c0pperdragon/ByteMachine/i8088/i8088board.pdf

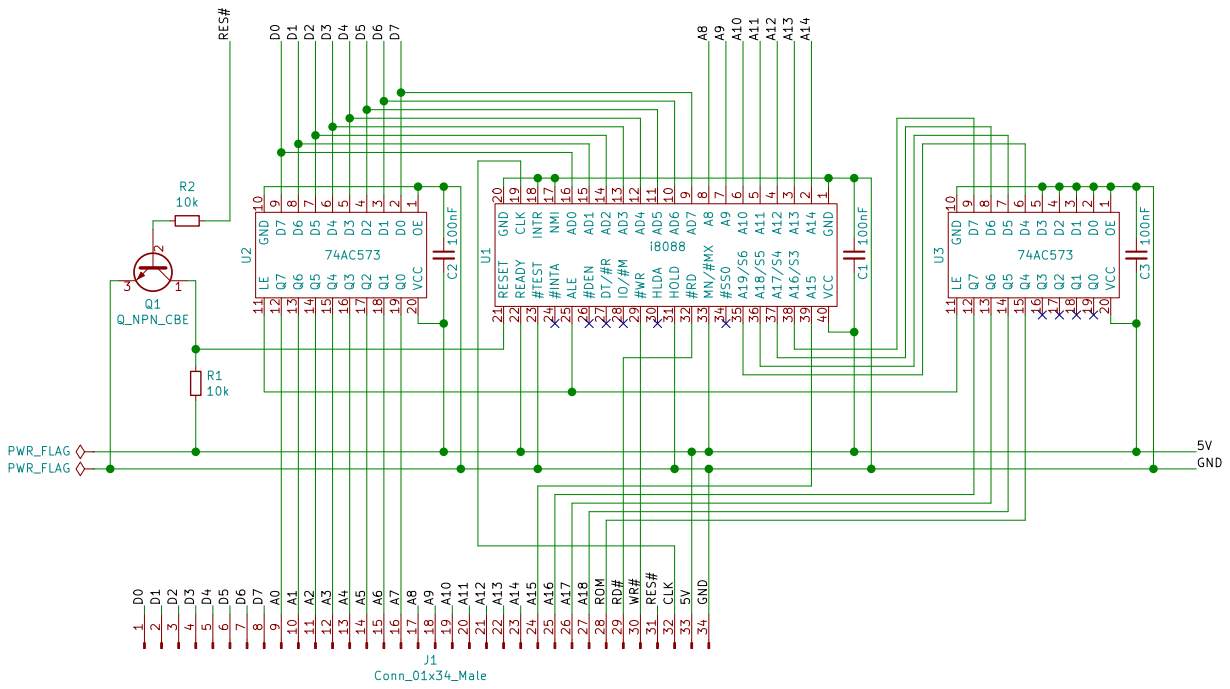
[picture p8: page 1]

2 GND 20 RESET 21 READY 22 #TEST 23 #INTA 24 ALE 25 #DEN 26 DT/#R 27 IO/#M 28 #WR 29 A13

3 HLDA 30 HOLD 31 #RD 32 MN/#MX 33 #SS0 34 A19/S6 35 A18/S5 36 A17/S4 37 A16/S3 38 A15 39 A12
