c0pperdragon/ByteMachine/z84c00/z84c00board.pdf

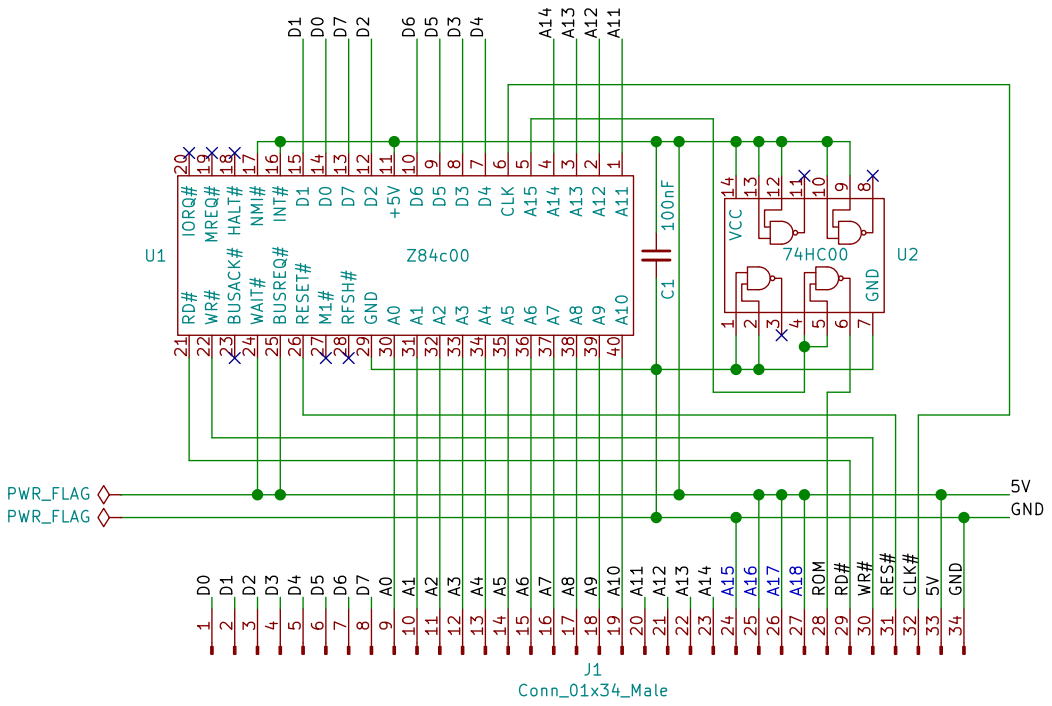
[picture p9: page 1]

2 IORQ# 20 RD# 21 WR# 22 BUSACK# 23 WAIT# 24 BUSREQ# 25 RESET# 26 M1# 27 RFSH# 28 GND 29 A13

1 D6 10 +5V 11 D2 12 D7 13 D0 14 D1 15 INT# 16 NMI# 17 HALT# 18 MREQ# 19 A12
