c0pperdragon/ByteMachine/6809/6809P-Schematic.pdf

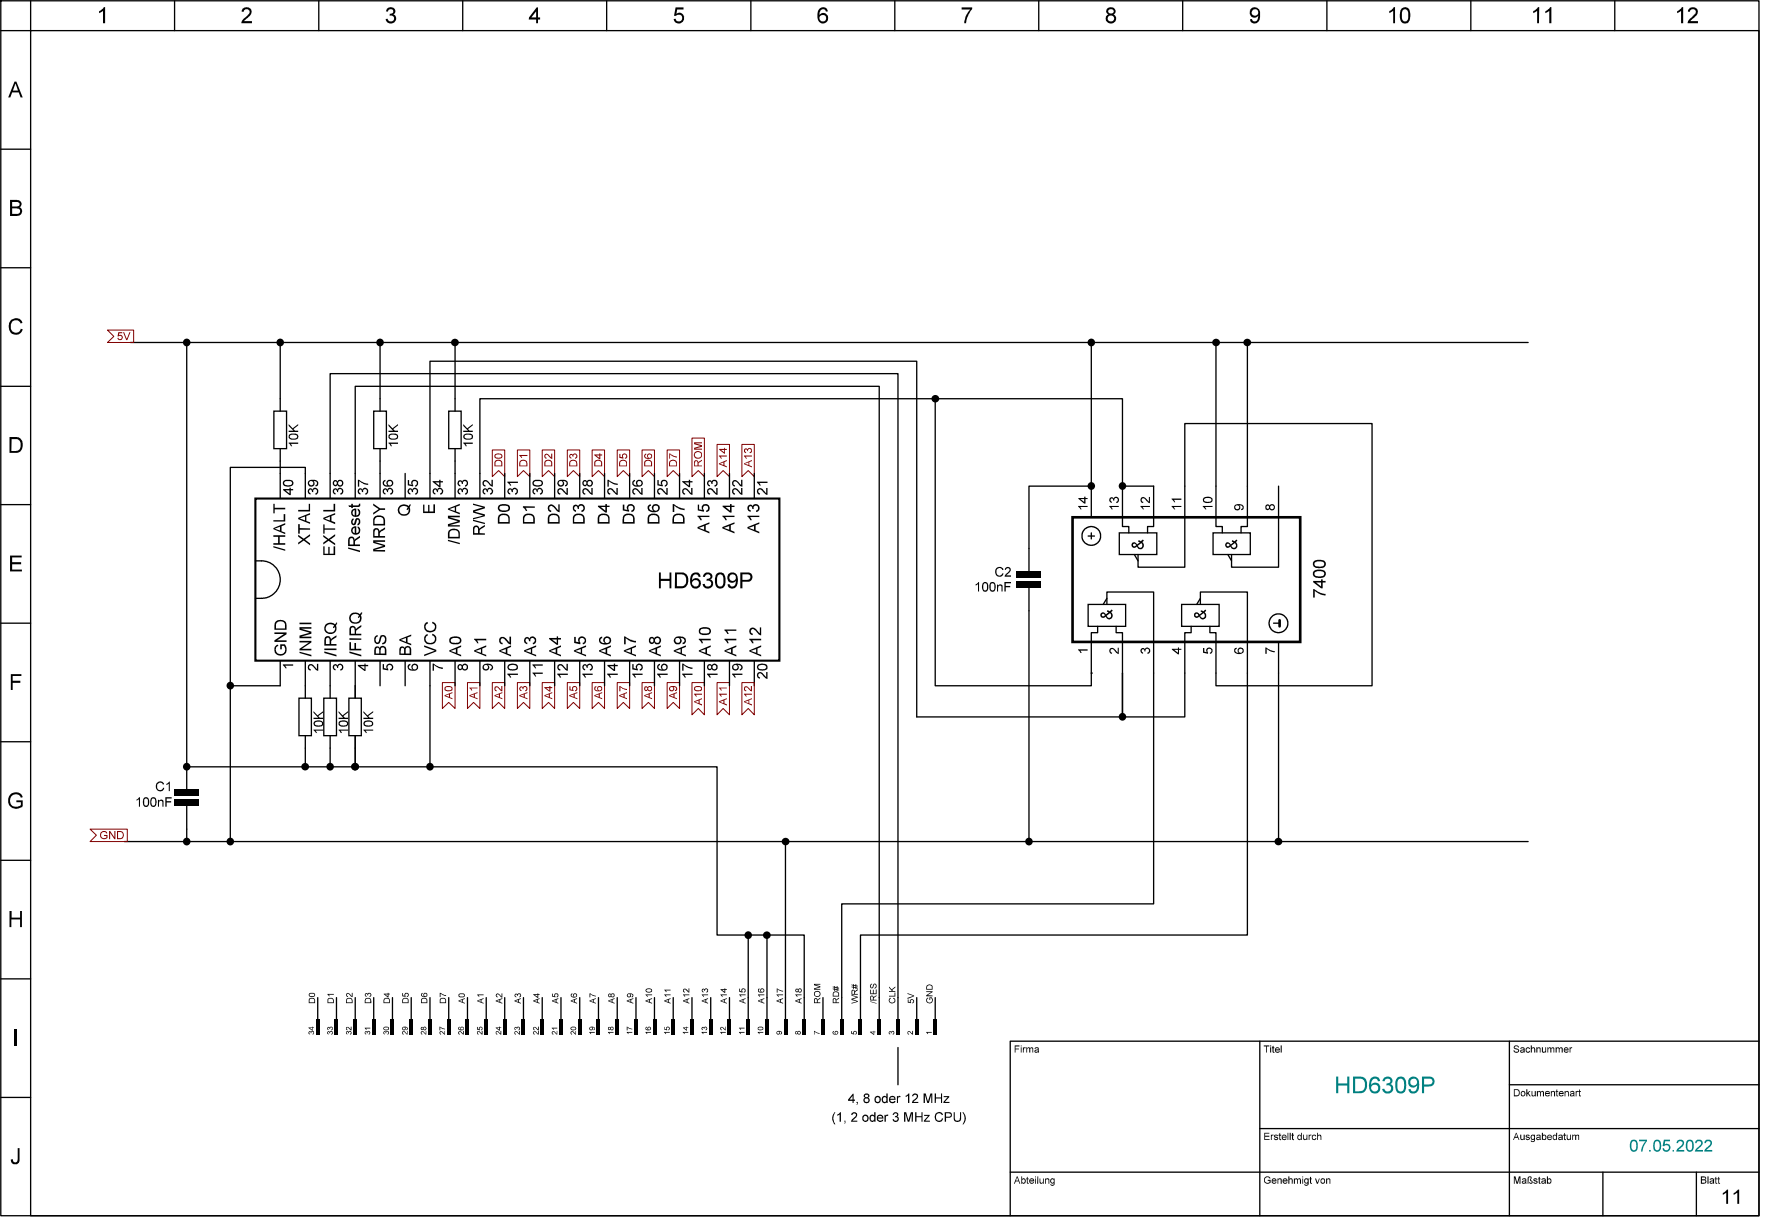
[picture p10: page 1]
