c0pperdragon/ByteMachine/IOexpander/ioexpanderboard.pdf

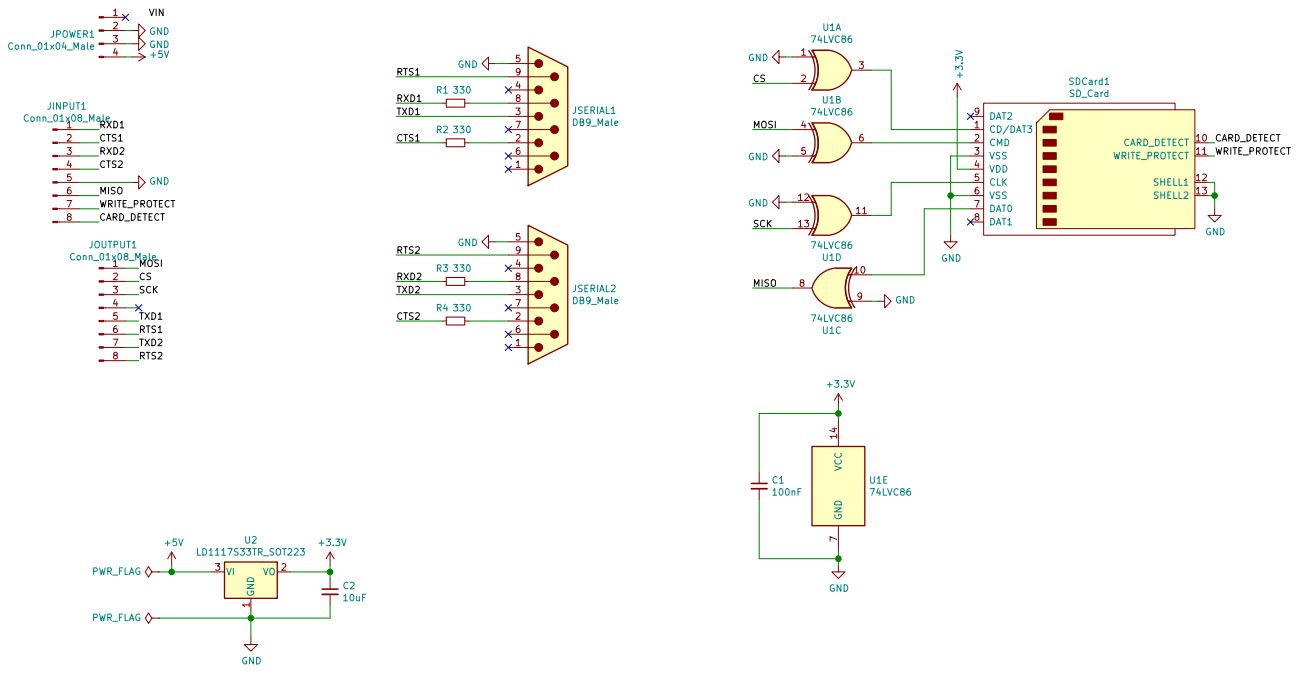
[picture p11: page 1]
