c0pperdragon/ByteMachine/65c02/65c02board.pdf

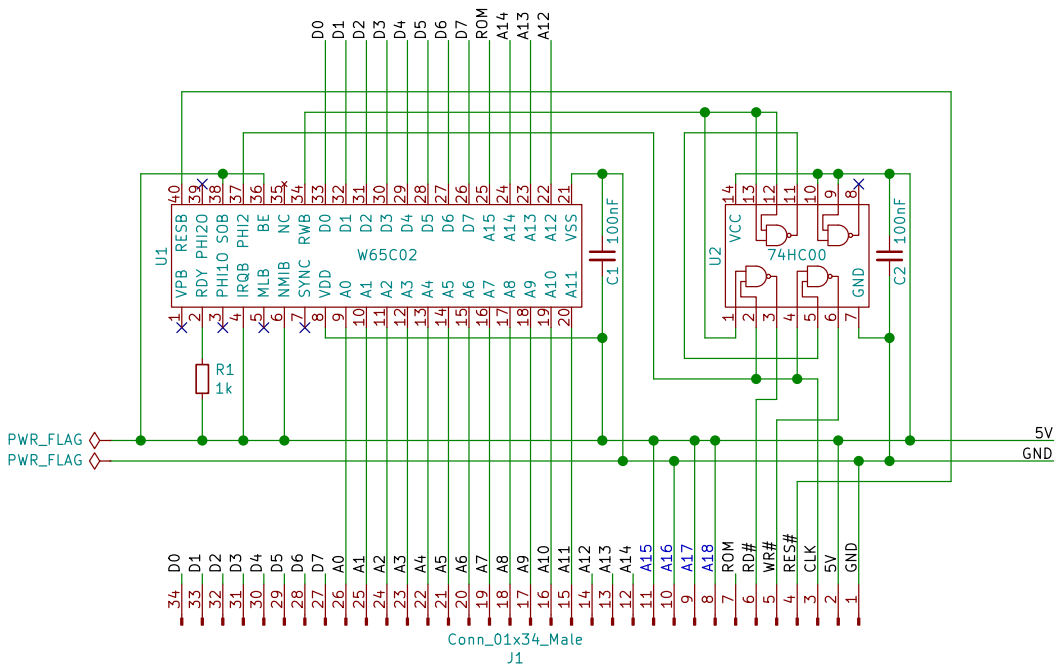
[picture p12: page 1]

3 D3 30 D2 31 D1 32 D0 33 RWB 34 NC 35 BE 36 PHI2 37 SOB 38 PHI2O 39 IRQB
