c0pperdragon/ByteMachine/mainboard/mainboard.pdf

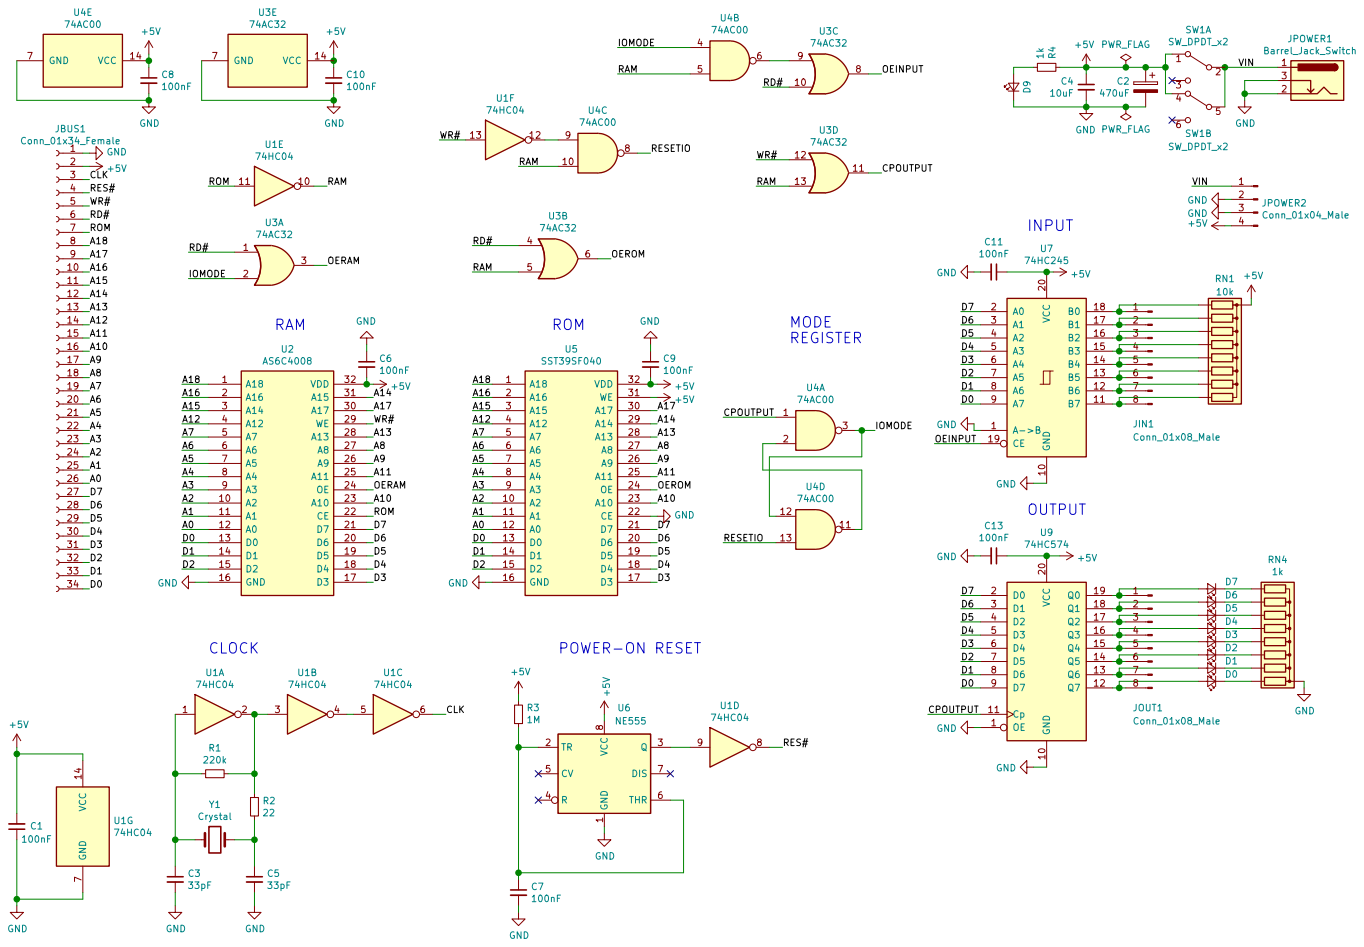
[picture p13: page 1]
