c0pperdragon/ByteMachine/65c816/65c816board.pdf

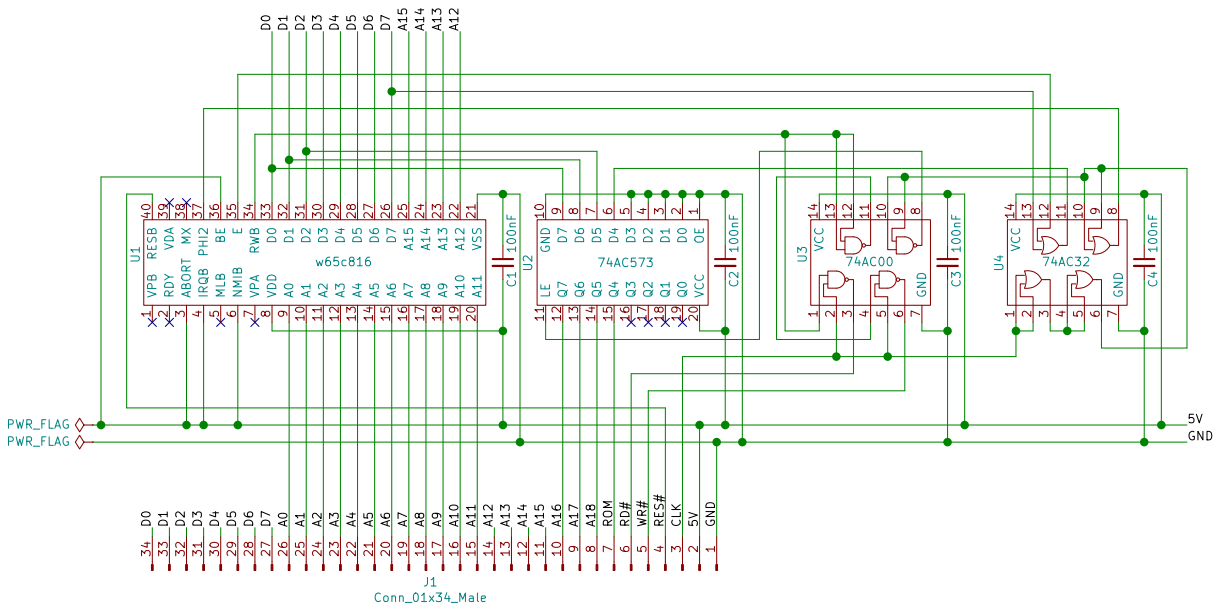
[picture p14: page 1]

3 D3 30 D2 31 D1 32 D0 33 RWB 34 E 35 BE 36 PHI2 37 MX 38 VDA 39 IRQB

9 U1 w65c816 D0 D1 D2 D3 D4 D5 D6 D7 RD# WR# RES# CLK 5VGND
