c0pperdragon/ByteMachine/IOexpander/ioexpanderboard/ioexpanderboard.kicad_pcb

## KiCad design IOexpander/ioexpanderboard/ioexpanderboard.kicad_pcb (2021-04-02)

Schematic: ioexpanderboard.sch

Parts:
C1: 100nF; C_0805_2012Metric_Pad1.15x1.40mm_HandSolder
C2: 10uF; C_0805_2012Metric_Pad1.15x1.40mm_HandSolder
JINPUT1: Conn_01x08_Male; PinHeader_1x08_P2.54mm_Vertical
JOUTPUT1: Conn_01x08_Male; PinHeader_1x08_P2.54mm_Vertical
JPOWER1: Conn_01x04_Male; PinHeader_1x04_P2.54mm_Vertical
JSERIAL1, JSERIAL2: DB9_Male; DSUB-9_Male_Horizontal_P2.77x2.54mm_EdgePinOffset9.40mm
R1, R2, R3, R4: 330; R_0805_2012Metric_Pad1.15x1.40mm_HandSolder
SDCard1: SD_Card; sdcardsocket
U1: 74LVC86; SOIC-14_3.9x8.7mm_P1.27mm
U2: LD1117S33TR_SOT223; SOT-223-3_TabPin2

Connections:
+3V3: C1.1, C2.1, SDCard1.4, U1.14 (VCC), U2.2 (VO)
+5V: JPOWER1.4, U2.3 (VI)
/CARD_DETECT: JINPUT1.8, SDCard1.10
/CS: JOUTPUT1.2, U1.2
/CTS1: JINPUT1.2, R2.2
/CTS2: JINPUT1.4, R4.2
/MISO: JINPUT1.6, U1.8
/MOSI: JOUTPUT1.1, U1.4
/RTS1: JOUTPUT1.6, JSERIAL1.9
/RTS2: JOUTPUT1.8, JSERIAL2.9
/RXD1: JINPUT1.1, R1.2
/RXD2: JINPUT1.3, R3.2
/SCK: JOUTPUT1.3, U1.13
/TXD1: JOUTPUT1.5, JSERIAL1.3
/TXD2: JOUTPUT1.7, JSERIAL2.3
/WRITE_PROTECT: JINPUT1.7, SDCard1.11
GND: C1.2, C2.2, JINPUT1.5, JPOWER1.2, JPOWER1.3, JSERIAL1.5, JSERIAL2.5, SDCard1.3, SDCard1.6, SDCard1.12, SDCard1.13, U1.1, U1.5, U1.7 (GND), U1.9, U1.12, U2.1 (GND)
unnamed: JSERIAL1.2, R2.1
unnamed: JSERIAL1.8, R1.1
unnamed: JSERIAL2.2, R4.1
unnamed: JSERIAL2.8, R3.1
unnamed: SDCard1.1, U1.3
unnamed: SDCard1.2, U1.6
unnamed: SDCard1.5, U1.11
unnamed: SDCard1.7, U1.10

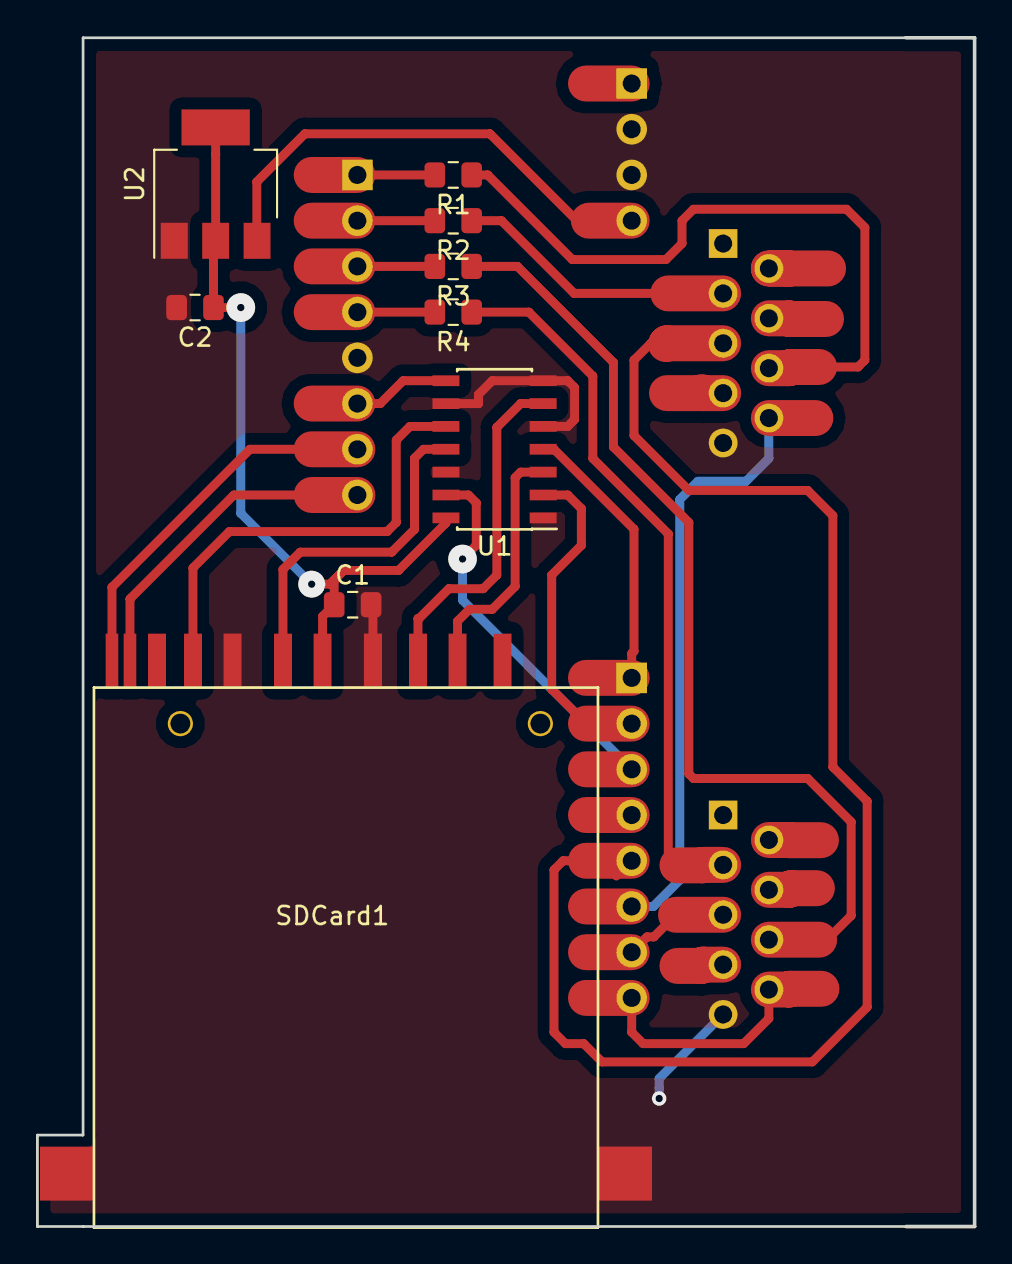
[picture p15: board ioexpanderboard.kicad_pcb from above]

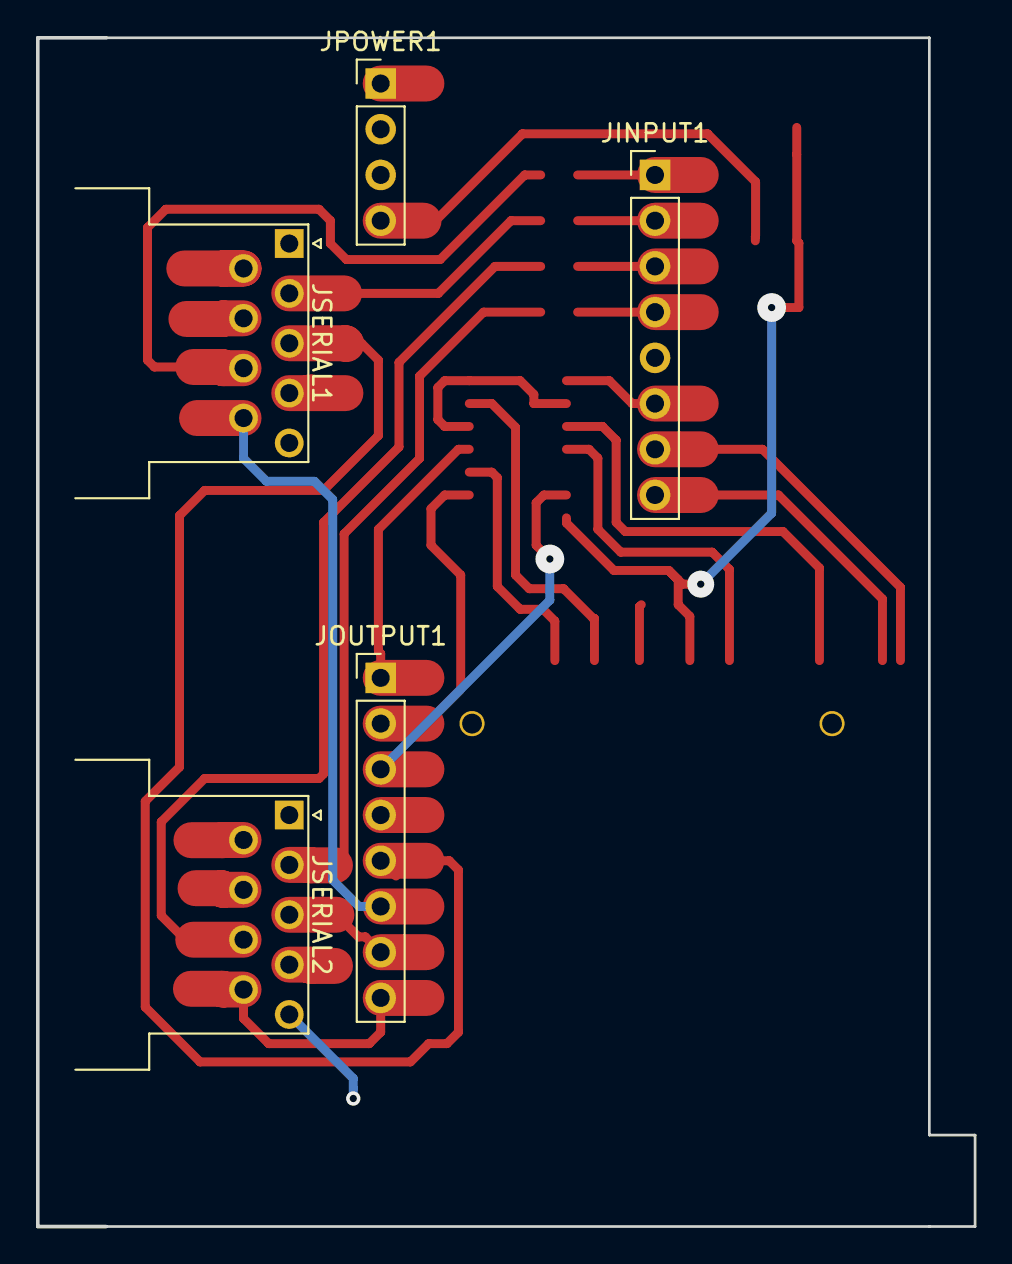
[picture p16: board ioexpanderboard.kicad_pcb from below]

Board: 2 copper layers, 52.1 x 66.0 mm, 14 parts (5 on the bottom side), 25 nets.
