c0pperdragon/ByteMachine/65c816/65c816board/65c816board.kicad_pcb

## KiCad design 65c816/65c816board/65c816board.kicad_pcb (2021-04-02)

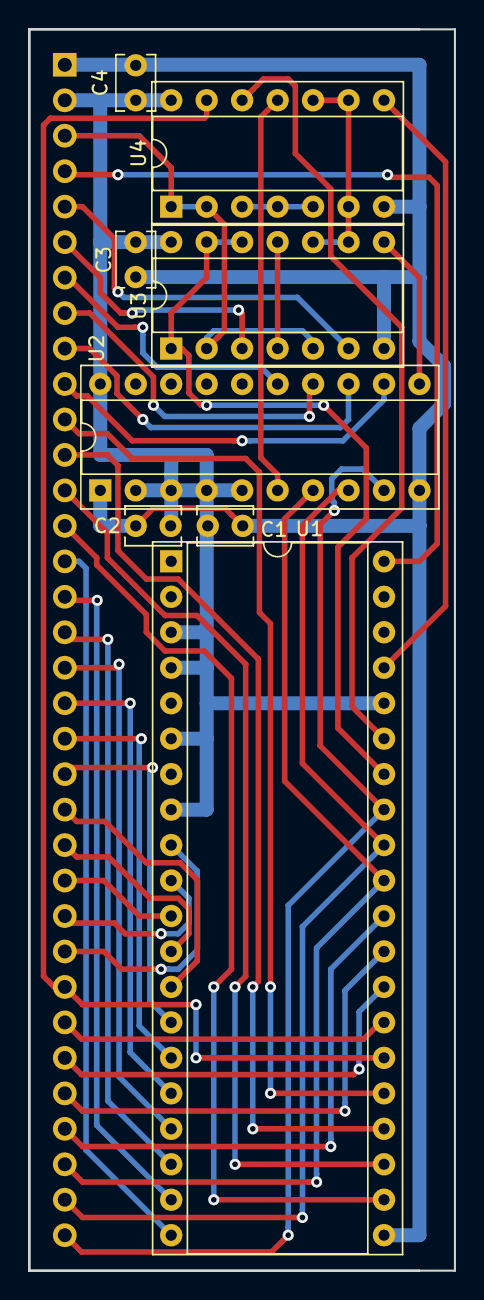
[picture p17: board 65c816board.kicad_pcb from above]

Board: 2 copper layers, 30.5 x 88.9 mm, 9 parts (1 on the bottom side), 42 nets.

Parts:
C1, C2, C3, C4: 100nF; C_Disc_D3.8mm_W2.6mm_P2.50mm
J1: Conn_01x34_Male; PinHeader_1x34_P2.54mm_Vertical
U1: w65c816; DIP-40_W15.24mm_Socket
U2: 74AC573; DIP-20_W7.62mm_Socket
U3: 74AC00; DIP-14_W7.62mm_Socket
U4: 74AC32; DIP-14_W7.62mm_Socket

Connections:
/5V: C1.2, C2.2, C3.1, C4.1, J1.2, U1.3, U1.4, U1.6, U1.8, U1.36, U2.2, U2.3, U2.4, U2.5, U2.20, U3.14, U4.14
/A0: J1.26, U1.9
/A1: J1.25, U1.10
/A2: J1.24, U1.11
/A3: J1.23, U1.12
/A4: J1.22, U1.13
/A5: J1.21, U1.14
/A6: J1.20, U1.15
/A7: J1.19, U1.16
/A8: J1.18, U1.17
/A9: J1.17, U1.18
/A10: J1.16, U1.19
/A11: J1.15, U1.20
/A12: J1.14, U1.22
/A13: J1.13, U1.23
/A14: J1.12, U1.24
/A15: J1.11, U1.25
/A16: J1.10, U2.12
/A17: J1.9, U2.13
/A18: J1.8, U2.14
/CLK: J1.3, U3.2, U3.5, U4.1, U4.2
/D0: J1.34, U1.33, U2.9
/D1: J1.33, U1.32, U2.8
/D2: J1.32, U1.31, U2.7
/D3: J1.31, U1.30
/D4: J1.30, U1.29
/D5: J1.29, U1.28
/D6: J1.28, U1.27
/D7: J1.27, U1.26, U4.13
/GND: C1.1, C2.1, C3.2, C4.2, J1.1, U1.21, U2.1, U2.10, U3.7, U4.7
/RD#: J1.6, U3.3
/RES#: J1.4, U1.40
/ROM: J1.7, U2.15
/WR#: J1.5, U3.6
unnamed: U1.34, U3.1, U3.12, U3.13
unnamed: U1.35, U4.12
unnamed: U1.37, U4.8
unnamed: U2.6, U4.11
unnamed: U2.11, U3.8
unnamed: U3.9, U3.10, U4.6, U4.9, U4.10
unnamed: U3.4, U3.11
unnamed: U4.3, U4.4, U4.5
