c0pperdragon/ByteMachine/mainboard/mainboard.kicad_pcb

## KiCad design mainboard/mainboard.kicad_pcb (2020-08-21)

Schematic: mainboard.sch, Byte machine - main board

Parts:
C1, C6, C7, C8, C9, C10, C11, C13: 100nF; C_Disc_D3.8mm_W2.6mm_P2.50mm
C2: 470uF; CP_Radial_D8.0mm_P5.00mm
C3, C5: 33pF; C_Disc_D5.0mm_W2.5mm_P5.00mm
C4: 10uF; C_Disc_D5.0mm_W2.5mm_P5.00mm
D0, D1, D2, D3, D4, D5, D6, D7, D9: LED_Small; LED_D3.0mm
JBUS1: Conn_01x34_Female; PinSocket_1x34_P2.54mm_Vertical
JIN1: Conn_01x08_Male; PinHeader_1x08_P2.54mm_Vertical
JOUT1: Conn_01x08_Male; PinHeader_1x08_P2.54mm_Vertical
JPOWER1: Barrel_Jack_Switch; BarrelJack_Horizontal
JPOWER2: Conn_01x04_Male; PinHeader_1x04_P2.54mm_Vertical
R1: 220k; R_Axial_DIN0207_L6.3mm_D2.5mm_P7.62mm_Horizontal
R2: 22; R_Axial_DIN0207_L6.3mm_D2.5mm_P7.62mm_Horizontal
R3: 1M; R_Axial_DIN0207_L6.3mm_D2.5mm_P7.62mm_Horizontal
R4: 1k; R_Axial_DIN0207_L6.3mm_D2.5mm_P7.62mm_Horizontal
RN1: 10k; R_Array_SIP9
RN4: 1k; R_Array_SIP9
SW1: SW_DPDT_x2; DPDS Switch
U1: 74HC04; DIP-14_W7.62mm_Socket
U2: AS6C4008; DIP-32_W15.24mm_Socket
U3: 74AC32; DIP-14_W7.62mm_Socket
U4: 74AC00; DIP-14_W7.62mm_Socket
U5: SST39SF040; DIP-32_LargeHoles
U6: NE555; DIP-8_W7.62mm
U7: 74HC245; DIP-20_W7.62mm_Socket
U9: 74HC574; DIP-20_W7.62mm_Socket
Y1: Crystal; Crystal_HC18-U_Vertical

Connections:
+5V: C1.2, C2.1, C4.1, C6.2, C8.1, C9.2, C10.1, C11.1, C13.1, JBUS1.2, JPOWER2.4, R3.2, R4.1, RN1.1, SW1.1, SW1.4, U1.14 (VCC), U2.32, U3.14, U4.14 (VCC), U5.31, U5.32, U6.8 (VCC), U7.20 (VCC), U9.20 (VCC)
/A0: JBUS1.26, U2.12, U5.12
/A1: JBUS1.25, U2.11, U5.11
/A2: JBUS1.24, U2.10, U5.10
/A3: JBUS1.23, U2.9, U5.9
/A4: JBUS1.22, U2.8, U5.8
/A5: JBUS1.21, U2.7, U5.7
/A6: JBUS1.20, U2.6, U5.6
/A7: JBUS1.19, U2.5, U5.5
/A8: JBUS1.18, U2.27, U5.27
/A9: JBUS1.17, U2.26, U5.26
/A10: JBUS1.16, U2.23, U5.23
/A11: JBUS1.15, U2.25, U5.25
/A12: JBUS1.14, U2.4, U5.4
/A13: JBUS1.13, U2.28, U5.28
/A14: JBUS1.12, U2.31, U5.29
/A15: JBUS1.11, U2.3, U5.3
/A16: JBUS1.10, U2.2, U5.2
/A17: JBUS1.9, U2.30, U5.30
/A18: JBUS1.8, U2.1, U5.1
/CLK: JBUS1.3, U1.6
/CPOUTPUT: U3.11, U4.1, U9.11 (Cp)
/D0: JBUS1.34, U2.13, U5.13, U7.9 (A7), U9.9 (D7)
/D1: JBUS1.33, U2.14, U5.14, U7.8 (A6), U9.8 (D6)
/D2: JBUS1.32, U2.15, U5.15, U7.7 (A5), U9.7 (D5)
/D3: JBUS1.31, U2.17, U5.17, U7.6 (A4), U9.6 (D4)
/D4: JBUS1.30, U2.18, U5.18, U7.5 (A3), U9.5 (D3)
/D5: JBUS1.29, U2.19, U5.19, U7.4 (A2), U9.4 (D2)
/D6: JBUS1.28, U2.20, U5.20, U7.3 (A1), U9.3 (D1)
/D7: JBUS1.27, U2.21, U5.21, U7.2 (A0), U9.2 (D0)
/IOMODE: U3.2, U4.3, U4.4, U4.12
/OEINPUT: U3.8, U7.19 (CE)
/OERAM: U2.24, U3.3
/OEROM: U3.6, U5.24
/RAM: U1.10, U3.5, U3.13, U4.5, U4.10
/RD#: JBUS1.6, U3.1, U3.4, U3.10
/RES#: JBUS1.4, U1.8
/RESETIO: U4.8, U4.13
/ROM: JBUS1.7, U1.11, U2.22
/VIN: JPOWER1.1, JPOWER2.1, SW1.2, SW1.5
/WR#: JBUS1.5, U1.13, U2.29, U3.12
GND: C1.1, C2.2, C3.2, C4.2, C5.2, C6.1, C7.2, C8.2, C9.1, C10.2, C11.2, C13.2, D9.1, JBUS1.1, JPOWER1.2, JPOWER1.3, JPOWER2.2, JPOWER2.3, RN4.1, U1.7 (GND), U2.16, U3.7, U4.7 (GND), U5.16, U5.22, U6.1 (GND), U7.1 (A->B), U7.10 (GND), U9.1 (OE), U9.10 (GND)
unnamed: C3.1, R1.2, U1.1, Y1.1
unnamed: C5.1, R2.2, Y1.2
unnamed: C7.1, R3.1, U6.2 (TR), U6.6 (THR)
unnamed: D0.1, RN4.2
unnamed: D0.2, JOUT1.8, U9.12 (Q7)
unnamed: D1.1, RN4.3
unnamed: D1.2, JOUT1.7, U9.13 (Q6)
unnamed: D2.1, RN4.4
unnamed: D2.2, JOUT1.6, U9.14 (Q5)
unnamed: D3.1, RN4.5
unnamed: D3.2, JOUT1.5, U9.15 (Q4)
unnamed: D4.1, RN4.6
unnamed: D4.2, JOUT1.4, U9.16 (Q3)
unnamed: D5.1, RN4.7
unnamed: D5.2, JOUT1.3, U9.17 (Q2)
unnamed: D6.1, RN4.8
unnamed: D6.2, JOUT1.2, U9.18 (Q1)
unnamed: D7.1, RN4.9
unnamed: D7.2, JOUT1.1, U9.19 (Q0)
unnamed: D9.2, R4.2
unnamed: JIN1.1, RN1.2, U7.18 (B0)
unnamed: JIN1.2, RN1.3, U7.17 (B1)
unnamed: JIN1.3, RN1.4, U7.16 (B2)
unnamed: JIN1.4, RN1.5, U7.15 (B3)
unnamed: JIN1.5, RN1.6, U7.14 (B4)
unnamed: JIN1.6, RN1.7, U7.13 (B5)
unnamed: JIN1.7, RN1.8, U7.12 (B6)
unnamed: JIN1.8, RN1.9, U7.11 (B7)
unnamed: R1.1, R2.1, U1.2, U1.3
unnamed: U1.4, U1.5
unnamed: U1.9, U6.3 (Q)
unnamed: U1.12, U4.9
unnamed: U3.9, U4.6
unnamed: U4.2, U4.11

Notes on the sheet:
RAM
ROM
INPUT
OUTPUT
MODE REGISTER
CLOCK
POWER-ON RESET

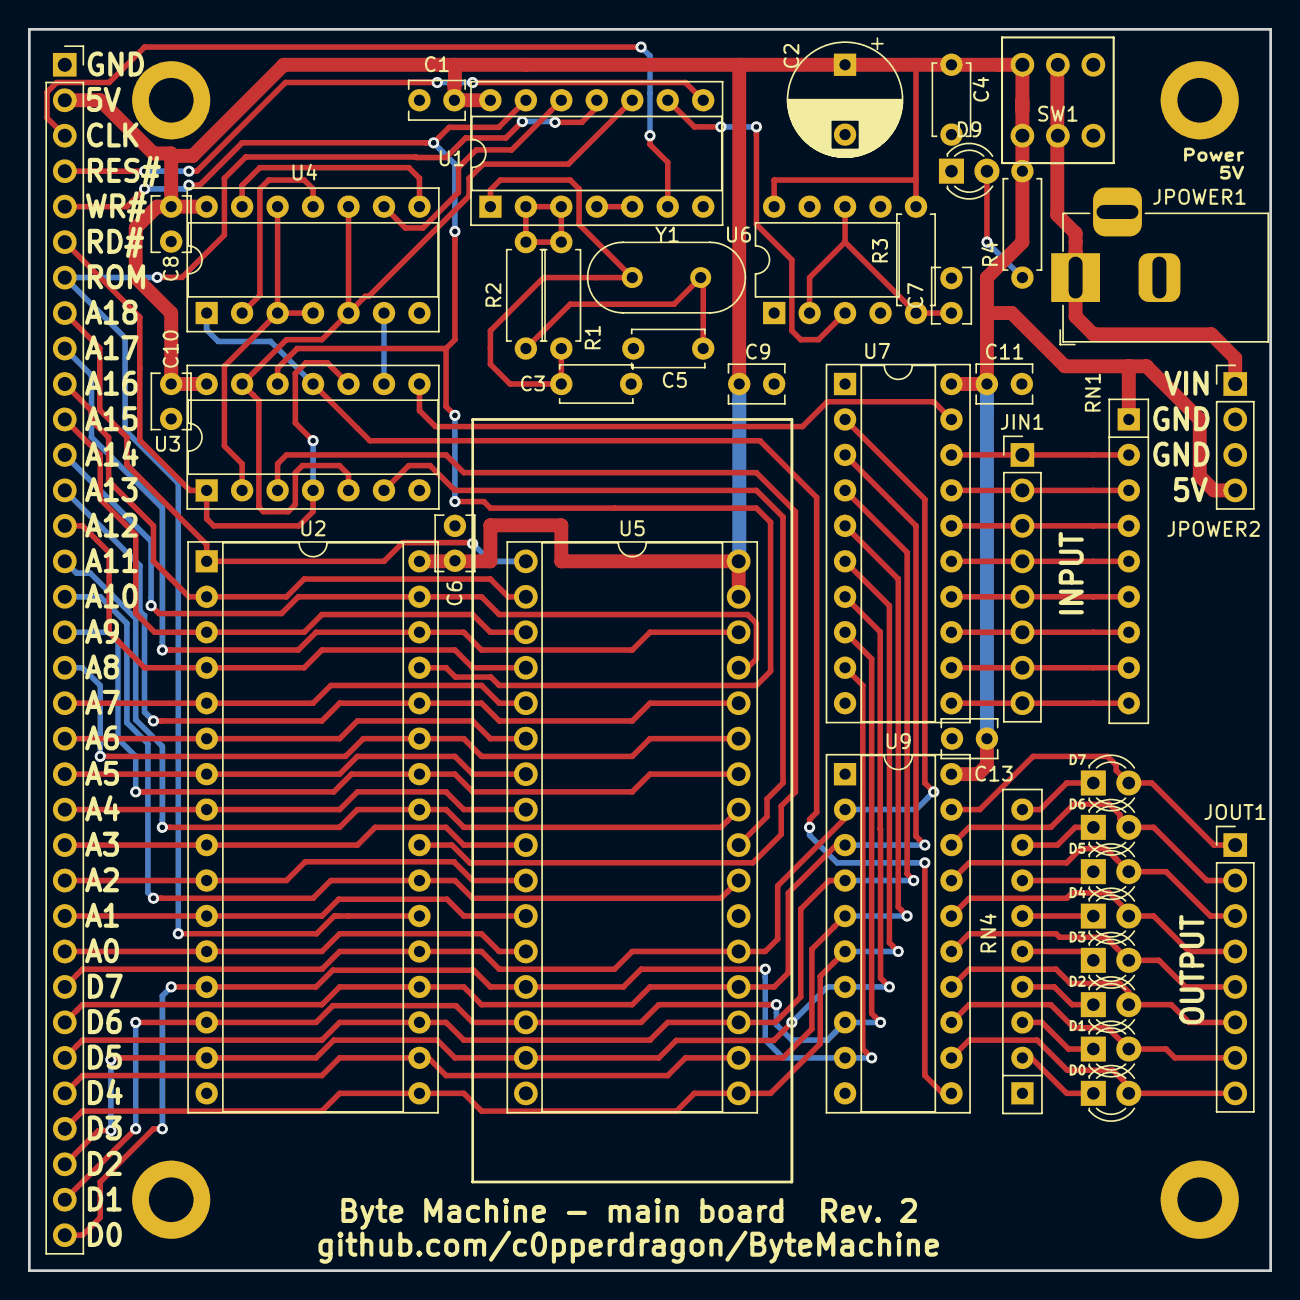
[picture p18: board mainboard.kicad_pcb from above]

Board: 2 copper layers, 88.9 x 88.9 mm, 42 parts (0 on the bottom side), 76 nets.
