c0pperdragon/ByteMachine/i8088/i8088board/i8088board.sch

## KiCad design i8088/i8088board/i8088board.sch (2020-09-03)

Schematic: i8088board.sch

Parts:
C1, C2, C3: 100nF
J1: Conn_01x34_Male
Q1: Q_NPN_CBE
R1, R2: 10k
U1: i8088
U2, U3: 74AC573
