c0pperdragon/ByteMachine/z84c00/z84c00board/z84c00board.sch

## KiCad design z84c00/z84c00board/z84c00board.sch (2020-06-28)

Schematic: z84c00board.sch

Parts:
C1: 100nF
J1: Conn_01x34_Male
U1: Z84c00
U2: 74HC00

Notes on the sheet:
A15
A16
A17
A18
