c0pperdragon/ByteMachine/(commit log)

2015-09-11 Working CPU. "Hello World!" sample running.
    [c5_pin_model_dump.txt]
2015-09-11 Assembler for ByteMachine code
2015-09-15 Simplified structure
    ByteMachine now uses one entity. On board design file, it is integrated
    with ram and io-blocks.
2015-09-23 More instruction set tweaks, Ultra-minimal CPU.
    I have decided to put the whole operand stack into a synchronous RAM (8
    MLABs on an Cyclone V) and use only the barest minimum of registers.
    Together with a mimimum ALU, This should lead to an extremly small
    footprint while still maintaining a reasonable speed.
2017-04-14 Ongoing development
    Assembler and virtual machine for die new ByteMachine
2017-05-02 Tweaking instruction set. More work on sample programs.
2017-05-03 Implement proof of concept
    Re-Implement the MD5 algorithm on the current ByteMachine instruction
    set. Very cumbersome, but can be done.
2017-05-12 Implemetation of new version in VHDL
    [c5_pin_model_dump.txt]
2020-05-26 Designing a generic main board
    [mainboard.kicad_pcb, mainboard.sch]
2020-05-29 Main board layout tweaks
    [mainboard.kicad_pcb, mainboard.sch]
2020-06-01 More PCB design First tiny program running
    [mainboard.kicad_pcb, mainboard.sch]
2020-06-04 Repurposing this repo (and product name) for my gernic 8-bit computer main board.
    [65c02board.kicad_pcb, 65c02board.sch, c5_pin_model_dump.txt, mainboard.kicad_pcb, mainboard.sch]
2020-06-05 Reworked schematics for the WD65C02 processor board.
    [65c02board.kicad_pcb, 65c02board.sch, _saved_65c02board.sch]
2020-06-07 Redesign port access to use a state flip-flop made of NANDs instead of wasting a bit of the dedicatd output IC.
    [65c02board.sch, _saved_65c02board.sch, mainboard.kicad_pcb, mainboard.sch]
2020-06-12 Rename A19 to RAM to create two distinct address spaces.
    [65c02board.sch, mainboard.kicad_pcb, mainboard.sch]
2020-06-12 Tweak schematics to only use one GND and one +5V rail
    [65c02board.kicad_pcb, 65c02board.sch]
2020-06-12 Start with 65C816 schematics
    [65c816board.kicad_pcb, 65c816board.sch]
2020-06-15 Breadboard layout for the 65C816 CPU board.
    [65c816board.sch]
2020-06-15 Rework schematics and documentation
    [65c02board.kicad_pcb, 65c02board.sch, 65c816board.sch]
2020-06-16 Working setup for the 65c816
    [65c816board.kicad_pcb, 65c816board.sch]
2020-06-17 Remove unnecessary pullup at Rdy pin
    [65c02board.kicad_pcb, 65c02board.sch, 65c816board.kicad_pcb, 65c816board.sch]
2020-06-20 Switch meaning of the A19 pin from RAM to ROM. Use pull-ups instead of pull-downs for the input port.
    [65c02board.kicad_pcb, 65c02board.sch, 65c816board.sch, mainboard.kicad_pcb, mainboard.sch]
2020-06-22 Add power input on pin header to allow USB device to drive the machine.
    [mainboard.kicad_pcb, mainboard.sch]
2020-06-24 Layout for 65C816 CPU board
    [65c816board.kicad_pcb, 65c816board.sch]
2020-06-24 Better layout for 65c816 CPU board
    [65c816board.kicad_pcb, 65c816board.sch]
2020-06-27 Remove protection resistors for input port. Stagger ports so an IO board will have better mechanical stability
    [mainboard.kicad_pcb, mainboard.sch]
2020-06-28 Schematic and test program for the Z84C00 processor
    [z84c00board.kicad_pcb, z84c00board.sch]
2020-06-28 Image of Z80 assembly
2020-06-28 Finshed layout for manifacture
    [_saved_mainboard.sch, mainboard.kicad_pcb]
2020-06-29 Update schematics
2020-07-08 Calibrate libraries to assume a 12Mhz clock
2020-07-08 UART send facility
2020-07-09 Bidirectional uart communication
2020-08-21 Modify memory map for the 65c02 to allow the P8088 to use the common rom image for simple test program without clashing.
    [65c02board.kicad_pcb, 65c02board.sch]
2020-08-21 Change mainboard to have larger holes for the ZIF socket and the power switch.
    [mainboard.kicad_pcb, mainboard.sch]
2020-08-22 Start with the i8088 board
    [i8088board.kicad_pcb, i8088board.sch]
2020-09-03 Circuit and test program for the Intel 8088
    [i8088board.sch]
2020-09-06 Design IO expander board and start programming
    [ioexpanderboard.kicad_pcb, ioexpanderboard.sch]
2020-10-05 Redefine ByteCPU to implement it in 7400 logic. Prototype of assembler.
    [ioexpanderboard.kicad_pcb, ioexpanderboard.sch]
2020-10-06 Intel hex format output from byte assembler
2020-10-09 Complete schematics for the ByteCPU
    [ALU.sch, Addressing.sch, Control.sch, cpuboard.kicad_pcb, cpuboard.sch, registers.sch]
2020-10-10 Fix mistake in SELPC signal generation. More docu.
    [Control.sch, cpuboard.sch, registers.sch]
2020-10-10 Share logic ICs between control and addressing to save 2 parts.
    [Addressing.sch, Control.sch]
2020-10-12 Ongoing development UART bridge
2020-10-13 Working version of SPI-to-UART bridge.
2020-10-19 Re-arrange the interconnect to better match the pin layout of the various chips.
    [ALU.sch, Addressing.sch, registers.sch]
2020-10-21 Modifications to fit the wiring to the physical layout of the 7400 logic. Bugfix: RD line was active during JMP instruction.
    [Addressing.sch, Control.sch, cpuboard.sch, registers.sch]
2020-10-21 Fixed assembler bug and bug in ledanimation program.
2020-10-23 Rework control logic to allow and additional IO instruction
    [Addressing.sch, Control.sch, cpuboard.sch]
2020-10-25 Rework all opcodes to speed up the decoding stage by 10 ns
    [ALU.sch, Addressing.sch, Control.sch, cpuboard.sch]
2020-10-26 Small fixes after rework
    [Control.sch, cpuboard.sch]
2020-10-26 Split off the breadbin to a different project.
    [ALU.sch, Addressing.sch, Control.sch, cpuboard.kicad_pcb, cpuboard.sch, registers.sch]
2021-04-02 Production files for cpu board. More work on IO expander board
    [65c816board.kicad_pcb, ioexpanderboard.kicad_pcb, ioexpanderboard.sch]
